TU-Darmstadt-APQ/Voltage_reference/(notices)

Notices in the files:
reference_board.kicad_pcb:
Copyright (©) 2024, Patrick Baus
Licensed under CERN OHL-W v2.0
